Adela683/PROIECT-TSC/Proiect TSC/Images/Screenshot 2025-04-06 233712.png

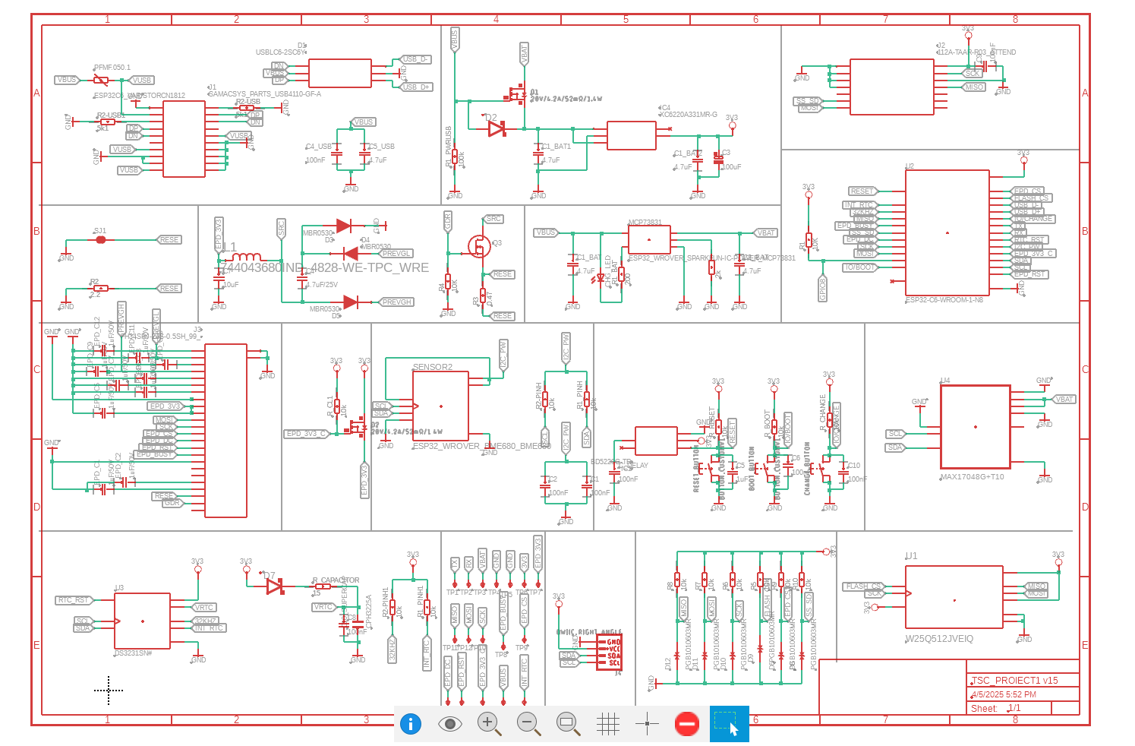
Proiect TSC/Images/Screenshot 2025-04-06 233712.png
