Adela683/PROIECT-TSC/Proiect TSC/Images/Screenshot 2025-04-16 131311.png

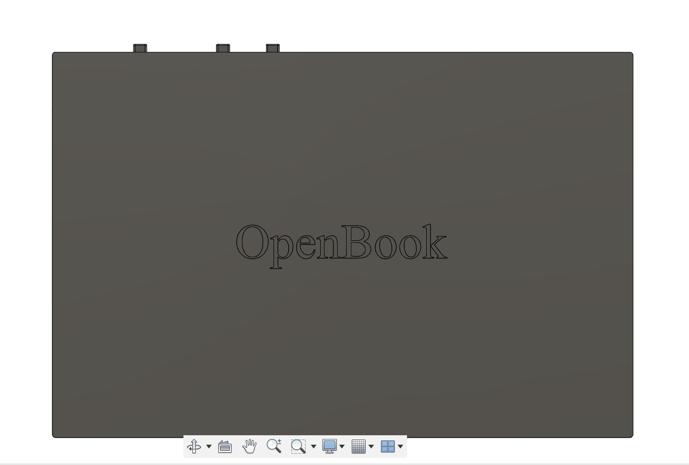
Proiect TSC/Images/Screenshot 2025-04-16 131311.png
